JBest0/proyecto1_arquitectura_de_computadores/README.md

# proyecto1_arquitectura_de_computadores
proyecto de arquitectura de computadores
