JBest0/proyecto1_arquitectura_de_computadores/Conexion al motor.png

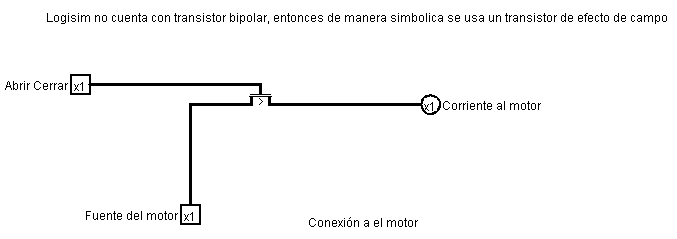
Conexion al motor.png
