JBest0/proyecto1_arquitectura_de_computadores/Entrada de datos.png

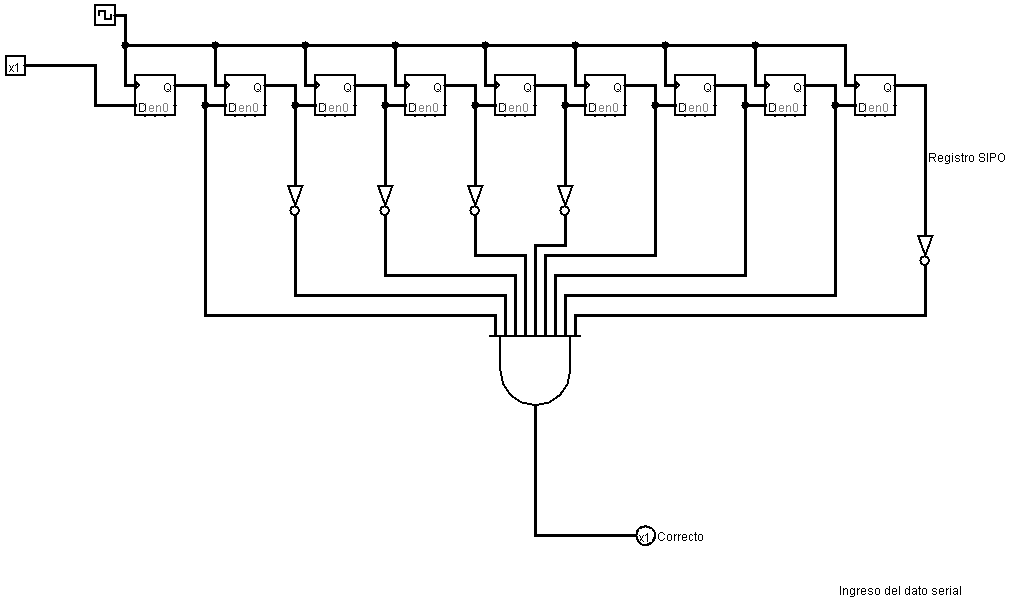
Entrada de datos.png
