JBest0/proyecto1_arquitectura_de_computadores/main.png

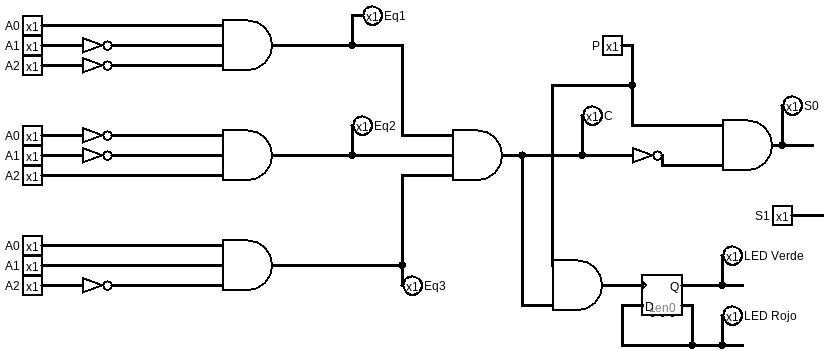
main.png
