JBest0/proyecto1_arquitectura_de_computadores/Mecanismo de cerrado.png

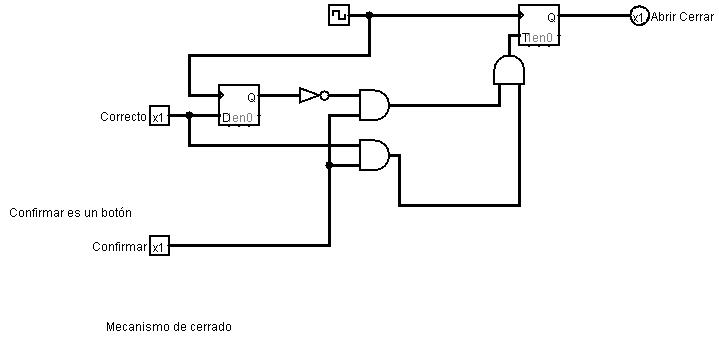
Mecanismo de cerrado.png
