JBest0/proyecto1_arquitectura_de_computadores/(list of files, drawings)

Other design files:
Conexion al motor.circ
Entrada de datos.circ
Logic_Simulation.circ
Mecanismo de cerrado.circ
