JBest0/proyecto1_arquitectura_de_computadores/(commit log)

2026-09-05 Add files via upload
    primer commit con diseño y simulación
    [Logic_Simulation.circ]
2026-09-16 Actualizacion de la bitacora
2026-09-18 actualizacion de la documentacion
2026-09-23 Se diseñó la entrada de datos y el mecanismo de cerrado
    [Entrada de datos.circ, Mecanismo de cerrado.circ]
2026-09-23 Circuitos para la conexión al motor
    [Conexion al motor.circ, Mecanismo de cerrado.circ]
